ccomincini/quad_watch_winder/2_orologi/1227833-arduino-double-watch-winder-4b0ba891-c772-4ddb-af0b-a195a3b41aa9.pdf

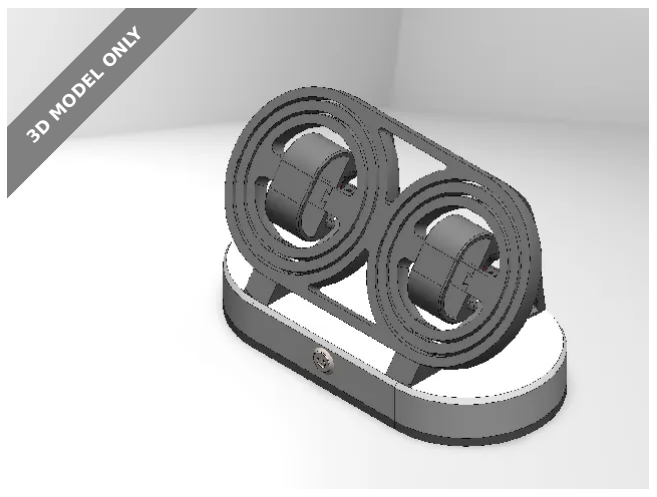
[picture p1: figure]
3D MODEL ONLY

## Summary

Device for spin up to two automatic watches

Hobby & Makers (https://printables.com/model?categoryId=48) > Electronics (https://printables.com/model?categoryId=52)

Functions

The watch winder keeps your automatic watch running when you're not wearing it. It's ideal if you own two watches and wear them alternately.

independently adjustable for both watches
adjustable spinning direction according to watch requirement adjustable spinning time according to watch requirement

Hardware and Software Used

Hardware:

1 pc. Arduino Uno
2 pcs. 28BYJ-48 Stepper Motor incl. Driver (Link) (https://de.aliexpress.com/item/1005007204939435.html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) 1 pc. 16mm Push Button (Link) (https://de.aliexpress.com/item/1005003595039032.html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)
10 pcs. Ball Bearing 603ZZ (Link) (https://de.aliexpress.com/item/1005004378774445.html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)
2 pcs. Ball Bearing SMR85ZZ (Link) (https://de.aliexpress.com/item/1005007618437178.html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)
22 pcs. Hex nut DIN934 - M3 (Link) (https://de.aliexpress.com/item/1005007593861199.html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)
22 pcs. Flat Head Screw ISO7380 - M3x6 (Link) (https://de.aliexpress.com/item/1005002136729466.html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) (IMPORTANT: Head Height max. 2mm)

JayS (https://printables.com/@JayS)

## Arduino Double Watch Winder

VIEW IN BROWSER (https://printables.com/model/1227833-arduino-double-watch-winder)

updated 6. 5. 2025 | published 6. 5. 2025

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
## Model files

18 pcs. Flat Head Screw ISO7380 - M3x10 (Link) (https://de.aliexpress.com/item/1005002136729466.html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) (IMPORTANT: Head Height max. 2mm)
Jumper cables for connection
USB cable for Arduino Uno

Software:

Tools used for development: Arduino IDE and Autodesk Inventor

Wiring Diagram

see Wiring.pdf

Code

see Code.ino. It includes descriptions for each section. To change runtime, adjust Step2Take value in the code.

Printing Instructions

prints great in PLA and also in PETG with some post processing of the parts. Simple open the 3MF file. It includes correct orientation and supports.

Assembly Instructions

For assembly please see the included pictures and especially the exploded view. I have also attached a .step file with the main parts.

•

•
•

uhrenbeweger.3mf

uhrenbeweger.step

## Other files

## License

This work is licensed under a
Creative Commons (4.0 International License)

Attribution—Noncommercial—Share Alike (http://creativecommons.org/licenses/by-nc-sa/4.0/)

✖ | Sharing without ATTRIBUTION
✔ | Remix Culture allowed
✖ | Commercial Use
✖ | Free Cultural Works
✖ | Meets Open Definition

code.ino

wiring.pdf
