ccomincini/quad_watch_winder/singolo/single-watch-winder-model_files/1290039-single-watch-winder-f3b908bd-97bc-490a-a9ca-4185cf84b470.pdf

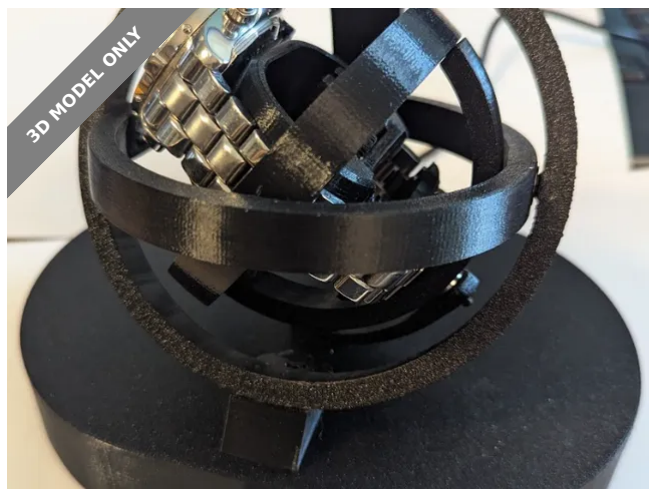
[picture p2: figure]
3D MODEL ONLY

## Summary

Device to keep an automatic winding watch wound.

Hobby & Makers (https://printables.com/model?categoryId=48) > Electronics (https://printables.com/model?categoryId=52)

Watch winder for a single watch. It's a remix of a double done to accommodate a single watch.

All parts per the original design except as follows:

New base (modified for a 5.5x2.1 power jack I had, plus a smaller power switch (NKK HB16 series that I also had)
New bottom cover (to match the new base)
New single outer ring

I used an Arduino Pro Micro (that I had on hand), so there are no mount holes for the Arduino. Code not attached here, as it's the same as the original, just with the second output commented out and adjusted for the Pro Micro pinout.

Remaining credit to @JayS for the original design.

## This remix is based on

R (https://printables.com/@RobbieKieffe_1050445) Robbie Kieffer (https://printables.com/@RobbieKieffe_1050445)

## Single Watch Winder

VIEW IN BROWSER (https://printables.com/model/1290039-single-watch-winder)

updated 8. 5. 2025 | published 8. 5. 2025

•

•
•

## Model files

Arduino Double Watch Winder (https://printables.com/model/1227833-arduino-double-watch-winder) by JayS (https://printables.com/@JayS)

## License

This work is licensed under a
Creative Commons (4.0 International License)

Attribution—Noncommercial—Share Alike (http://creativecommons.org/licenses/by-nc-sa/4.0/)

✖ | Sharing without ATTRIBUTION
✔ | Remix Culture allowed
✖ | Commercial Use
✖ | Free Cultural Works
✖ | Meets Open Definition

watchwinder_single_body.stl

watchwinder_single_base.stl

watchwinder_singlering.stl
