ccomincini/quad_watch_winder/2_orologi/uhrenbeweger.step

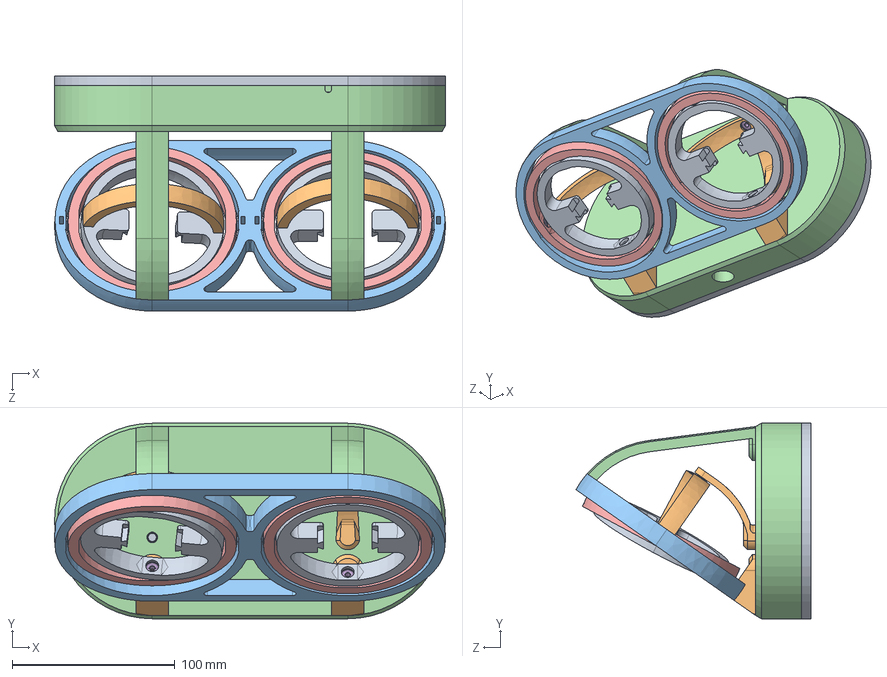
[picture p3: CAD file, 2026-10-13]
2_orologi/uhrenbeweger.step
240.0 x 120.0 x 144.3 mm
Deckel_R01.ipt
Sockel_links_unten_R01.ipt
Sockel_rechts_unten_R01.ipt
Ring_außen_R01.ipt
Sockel_links_oben_R01.ipt
Sockel_rechts_oben_R01.ipt
Ring_mitte_R01.ipt x 2
W 603 X-2Z_PART1.ipt x 10
W 603 X-2Z_PART2.ipt x 10
W 603 X-2Z_PART3.ipt x 60
Ring_innen_R01.ipt x 2
Ring_innen_Beweger_R01.ipt x 2
Motor.ipt
Gehäuse_R02.ipt
inafag_smr85-2z_ap1q6cxd37tek3q3ruj9lu0ju_01.ipt x 2
inafag_smr85-2z_ap1q6cxd37tek3q3ruj9lu0ju_02.ipt x 2
inafag_smr85-2z_ap1q6cxd37tek3q3ruj9lu0ju_03.ipt x 2
inafag_smr85-2z_ap1q6cxd37tek3q3ruj9lu0ju_04.ipt x 2
inafag_smr85-2z_ap1q6cxd37tek3q3ruj9lu0ju_05.ipt x 2
inafag_smr85-2z_ap1q6cxd37tek3q3ruj9lu0ju_06.ipt x 2
inafag_smr85-2z_ap1q6cxd37tek3q3ruj9lu0ju_07.ipt x 2
inafag_smr85-2z_ap1q6cxd37tek3q3ruj9lu0ju_08.ipt x 2
inafag_smr85-2z_ap1q6cxd37tek3q3ruj9lu0ju_09.ipt x 2
inafag_smr85-2z_ap1q6cxd37tek3q3ruj9lu0ju_10.ipt x 2
inafag_smr85-2z_ap1q6cxd37tek3q3ruj9lu0ju_11.ipt x 2
inafag_smr85-2z_ap1q6cxd37tek3q3ruj9lu0ju_12.ipt x 2
inafag_smr85-2z_ap1q6cxd37tek3q3ruj9lu0ju_13.ipt x 2
inafag_smr85-2z_ap1q6cxd37tek3q3ruj9lu0ju_14.ipt x 2
inafag_smr85-2z_ap1q6cxd37tek3q3ruj9lu0ju_15.ipt x 2
Beweger_R02.ipt
