ccomincini/quad_watch_winder/2_orologi/watchwinder_2_posti_stl/Uhrenbeweger.iam_watchwinder_2_posti v3_Sockel_rechts_oben_R01.ipt_1_Corpo1.stl

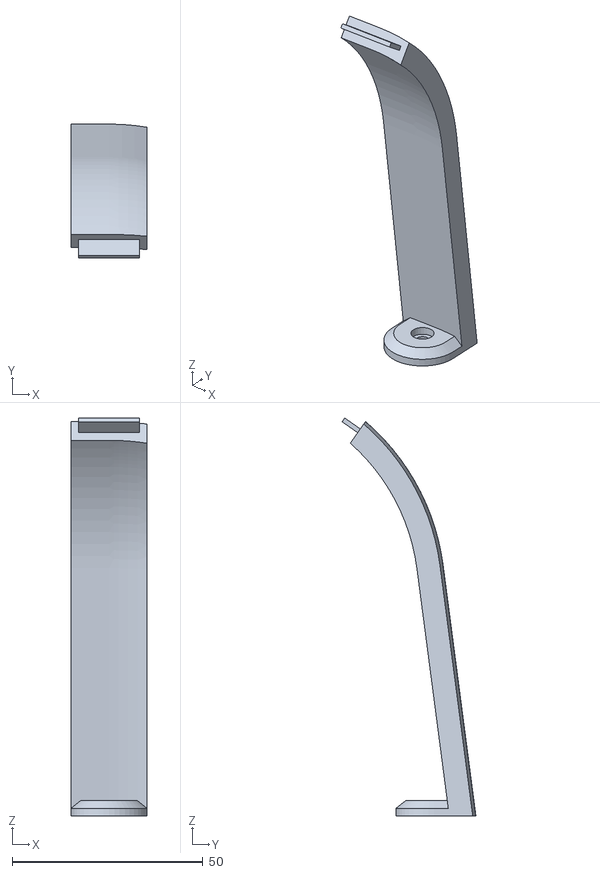
[picture p4: CAD file, 2026-11-06]
2_orologi/watchwinder_2_posti_stl/Uhrenbeweger.iam_watchwinder_2_posti v3_Sockel_rechts_oben_R01.ipt_1_Corpo1.stl
20.0 x 35.1 x 104.3
