ccomincini/quad_watch_winder/quad-watch-winder-model_files/base_3.stl

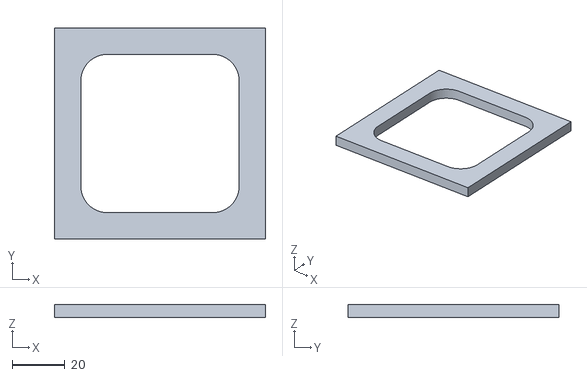
[picture p5: CAD file, 2026-09-02]
quad-watch-winder-model_files/base_3.stl
80.0 x 80.0 x 5.00
