ccomincini/quad_watch_winder/singolo/single-watch-winder-model_files/watchwinder_single_base_round.stl

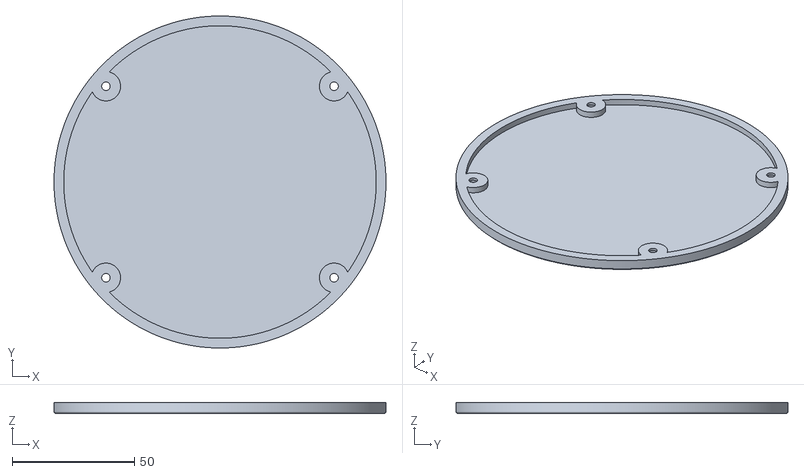
[picture p6: CAD file, 2026-11-06]
singolo/single-watch-winder-model_files/watchwinder_single_base_round.stl
136.0 x 136.0 x 4.50
