ccomincini/quad_watch_winder/singolo/singolo.3mf

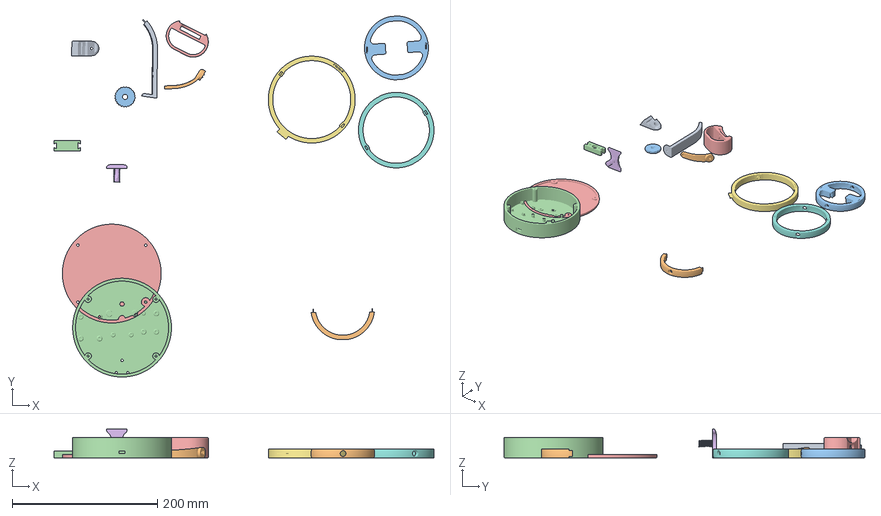
[picture p7: CAD file, 2026-11-06]
singolo/singolo.3mf
523.2 x 497.0 x 39.7 mm
Sockel_links_oben_R01.stl
Ring_innen_Beweger_R01.stl
Ring_innen_R01.stl
watchwinder_single_body_round.stl
Uhrträger_R01.stl
Uhrträger_Block_R03.stl
watchwinder_singlering.stl
Ring_mitte_R01.stl
Sockel_links_unten_R01.stl
Beweger_R02.stl
Uhrträger_Handrad_R03.stl
Uhrträger_Strebe_R01.stl
watchwinder_single_base_round.stl
