ccomincini/quad_watch_winder/2_orologi/watchwinder_2_posti_stl/Uhrenbeweger.iam_watchwinder_2_posti v3_Gehäuse_R02.ipt_1_Corpo1.stl

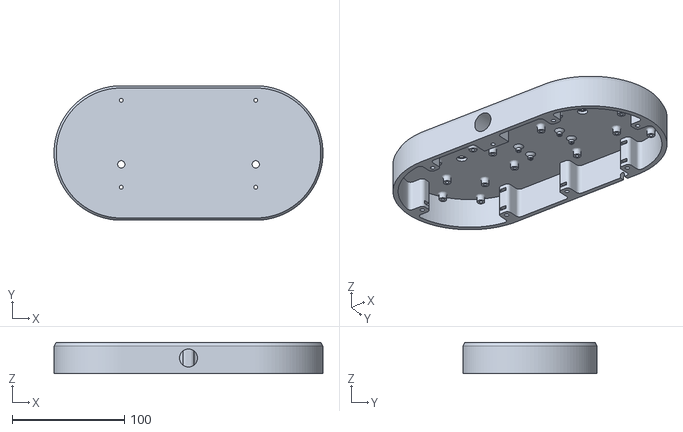
[picture p8: CAD file, 2026-11-06]
2_orologi/watchwinder_2_posti_stl/Uhrenbeweger.iam_watchwinder_2_posti v3_Gehäuse_R02.ipt_1_Corpo1.stl
240.0 x 120.0 x 28.0
