ccomincini/quad_watch_winder/quad-watch-winder-model_files/midplate.stl

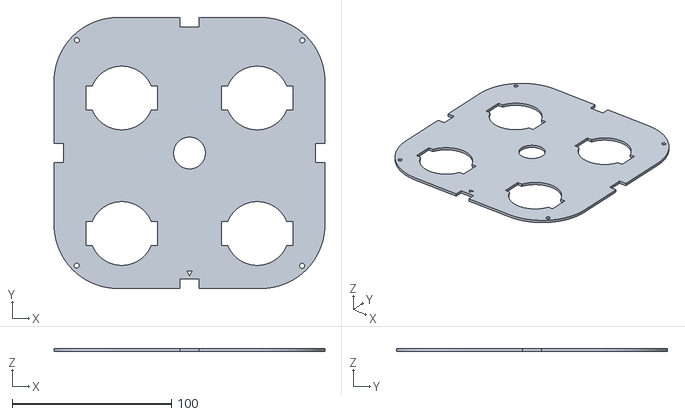
[picture p9: CAD file, 2026-09-02]
quad-watch-winder-model_files/midplate.stl
170.0 x 170.0 x 2.00
