ccomincini/quad_watch_winder/singolo/single-watch-winder-model_files/watchwinder_single_body_round.stl

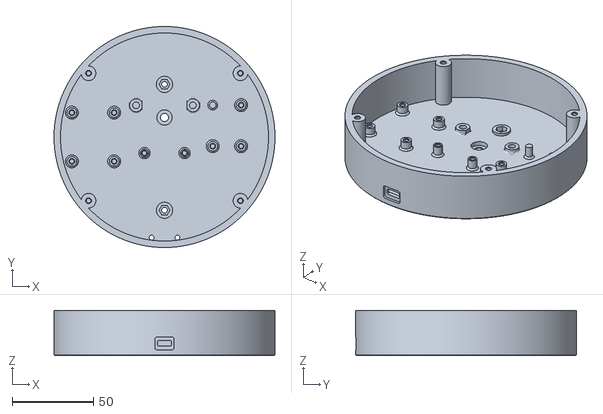
[picture p10: CAD file, 2026-11-06]
singolo/single-watch-winder-model_files/watchwinder_single_body_round.stl
136.0 x 136.0 x 28.0
