ccomincini/quad_watch_winder/quad-watch-winder-model_files/base_1.stl

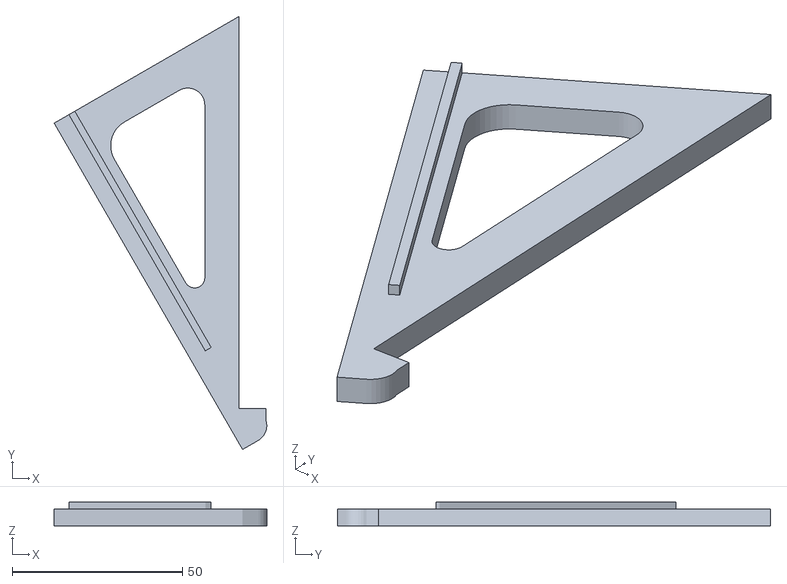
[picture p12: CAD file, 2026-09-02]
quad-watch-winder-model_files/base_1.stl
62.4 x 127.0 x 7.00
