ccomincini/quad_watch_winder/singolo/single-watch-winder-model_files/watchwinder_single_body_nodemcu.stl

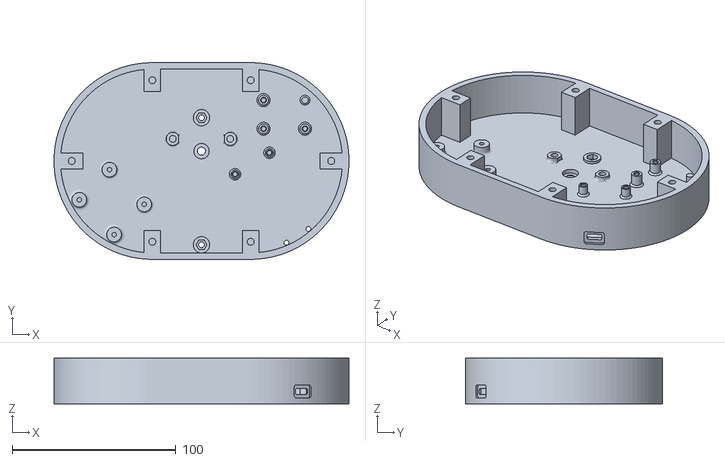
[picture p13: CAD file, 2026-11-01]
singolo/single-watch-winder-model_files/watchwinder_single_body_nodemcu.stl
179.9 x 120.0 x 28.0
