ccomincini/quad_watch_winder/2_orologi/watchwinder_2_posti_stl/Uhrenbeweger.iam_watchwinder_2_posti v3_Ring_mitte_R01.ipt_2_Corpo1.stl

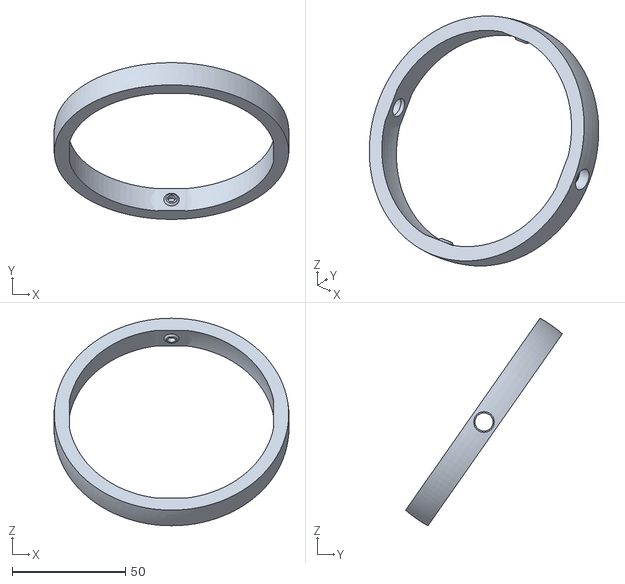
[picture p14: CAD file, 2026-11-06]
2_orologi/watchwinder_2_posti_stl/Uhrenbeweger.iam_watchwinder_2_posti v3_Ring_mitte_R01.ipt_2_Corpo1.stl
103.6 x 69.1 x 91.5
