ccomincini/quad_watch_winder/quad-watch-winder-model_files/plug.stl

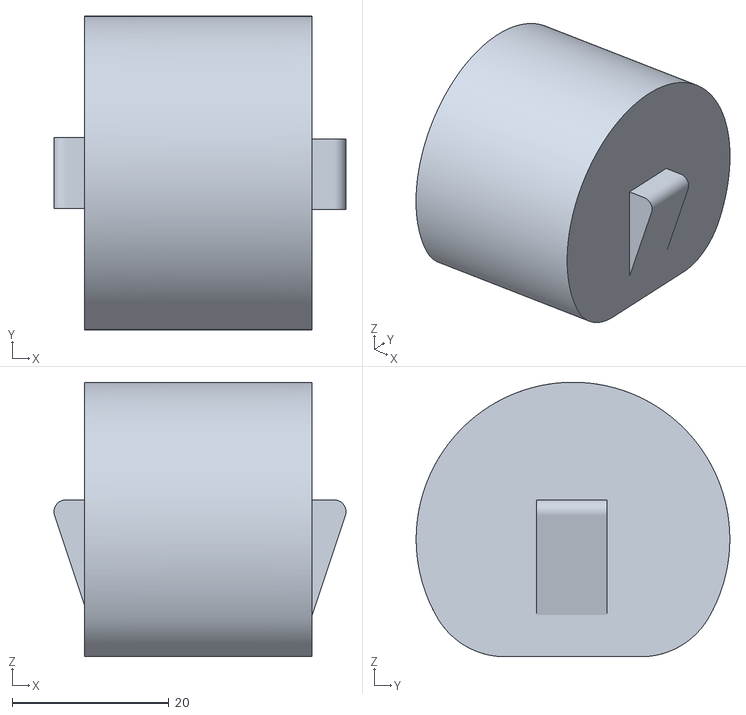
[picture p15: CAD file, 2026-09-02]
quad-watch-winder-model_files/plug.stl
37.2 x 40.0 x 35.0
