ccomincini/quad_watch_winder/singolo/single-watch-winder-model_files/Beweger_R02.stl

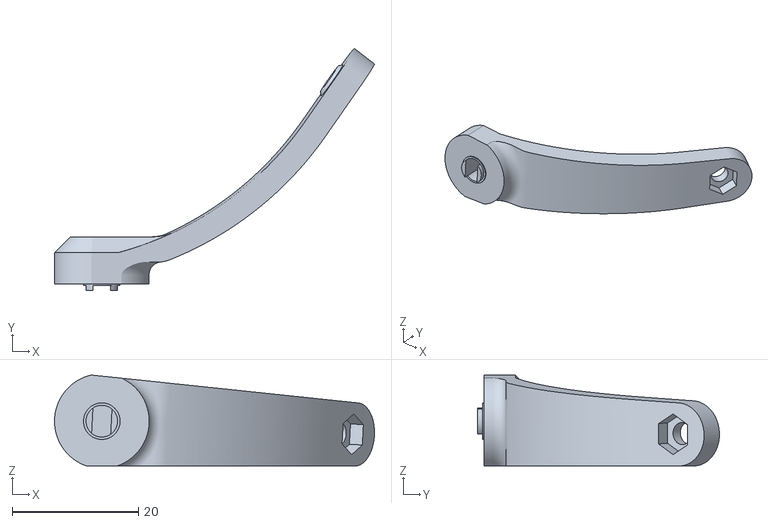
[picture p16: CAD file, 2026-10-30]
singolo/single-watch-winder-model_files/Beweger_R02.stl
50.7 x 38.3 x 14.4
