ccomincini/quad_watch_winder/2_orologi/watchwinder_2_posti_stl/Uhrenbeweger.iam_watchwinder_2_posti v3_Ring_innen_R01.ipt_1_Corpo1.stl

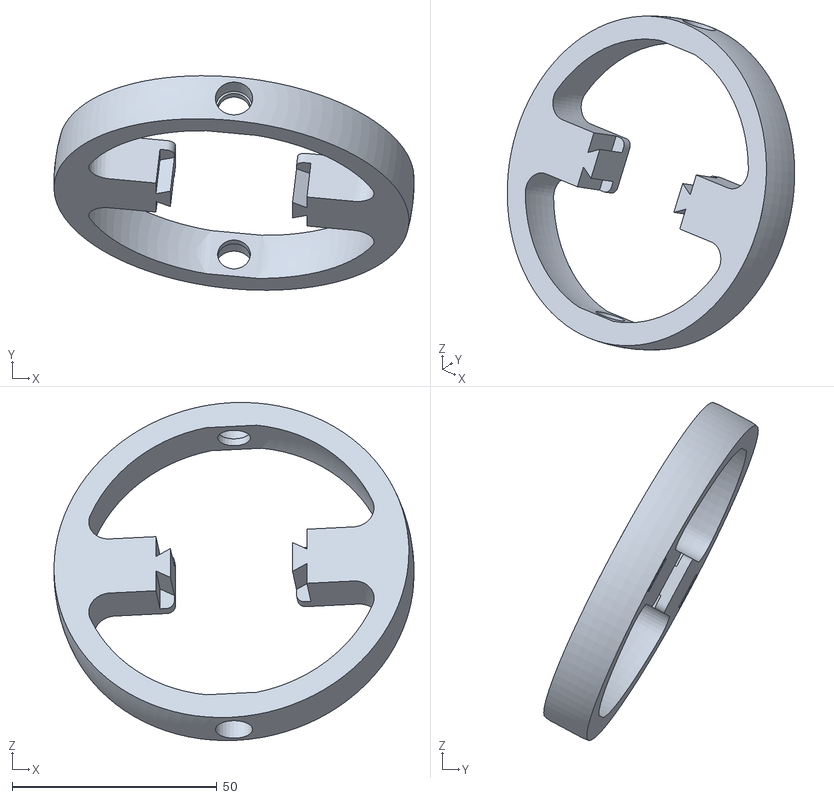
[picture p17: CAD file, 2026-11-06]
2_orologi/watchwinder_2_posti_stl/Uhrenbeweger.iam_watchwinder_2_posti v3_Ring_innen_R01.ipt_1_Corpo1.stl
88.0 x 52.4 x 82.6
