ccomincini/quad_watch_winder/quad-watch-winder-model_files/holder-foro-allargato.stl

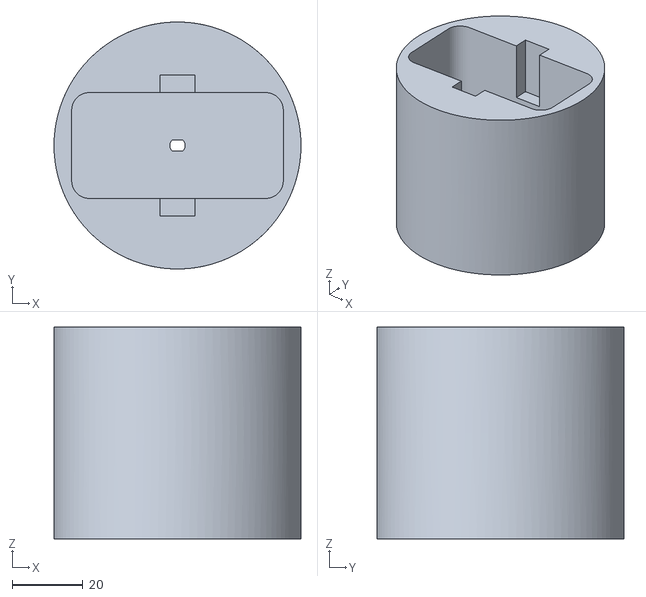
[picture p18: CAD file, 2026-09-02]
quad-watch-winder-model_files/holder-foro-allargato.stl
70.0 x 70.0 x 60.0
