ccomincini/quad_watch_winder/singolo/single-watch-winder-model_files/watchwinder_singlering.stl

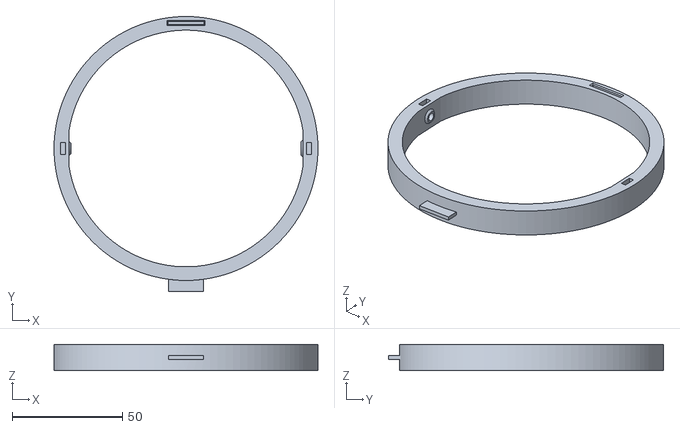
[picture p19: CAD file, 2026-10-30]
singolo/single-watch-winder-model_files/watchwinder_singlering.stl
119.6 x 124.6 x 12.0
