ccomincini/quad_watch_winder/singolo/single-watch-winder-model_files/Ring_mitte_R01.stl

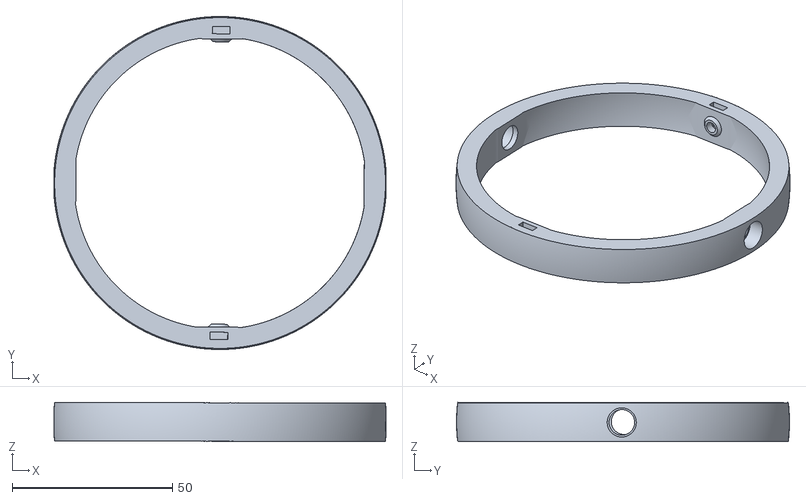
[picture p21: CAD file, 2026-10-30]
singolo/single-watch-winder-model_files/Ring_mitte_R01.stl
103.7 x 104.0 x 12.3
