ccomincini/quad_watch_winder/singolo/single-watch-winder-model_files/Uhrträger_Block_R03.stl

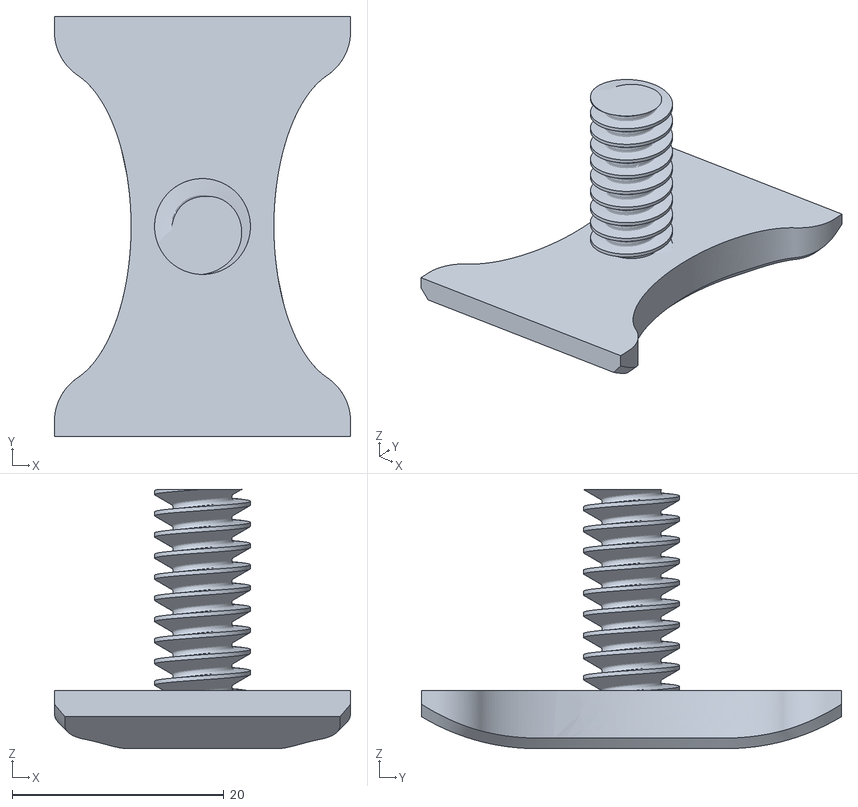
[picture p22: CAD file, 2026-10-30]
singolo/single-watch-winder-model_files/Uhrträger_Block_R03.stl
28.0 x 39.7 x 24.5
