ccomincini/quad_watch_winder/2_orologi/watchwinder_2_posti_stl/Uhrenbeweger.iam_watchwinder_2_posti v3_Ring_mitte_R01.ipt_1_Corpo1.stl

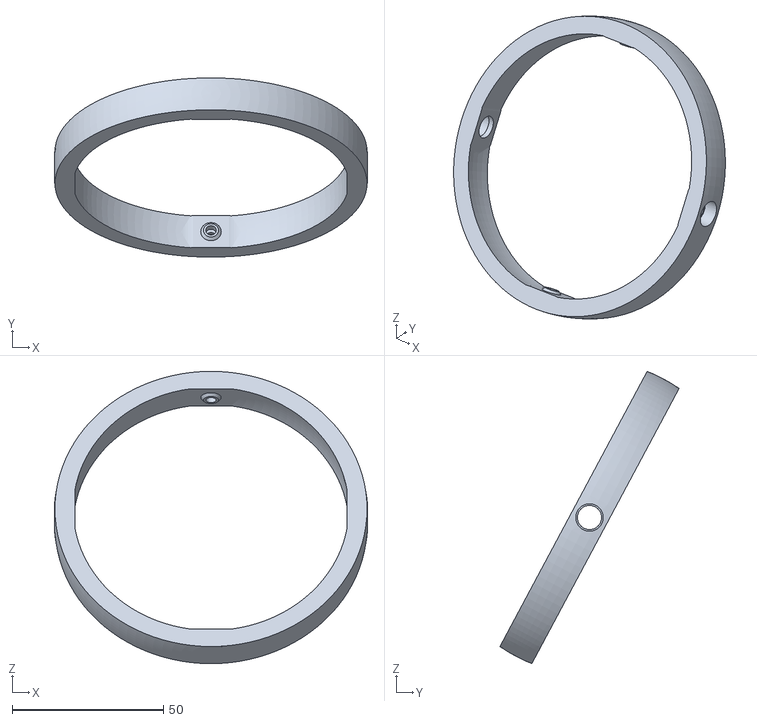
[picture p23: CAD file, 2026-11-06]
2_orologi/watchwinder_2_posti_stl/Uhrenbeweger.iam_watchwinder_2_posti v3_Ring_mitte_R01.ipt_1_Corpo1.stl
103.6 x 59.3 x 96.7
