ccomincini/quad_watch_winder/quad-watch-winder-model_files/cover.stl

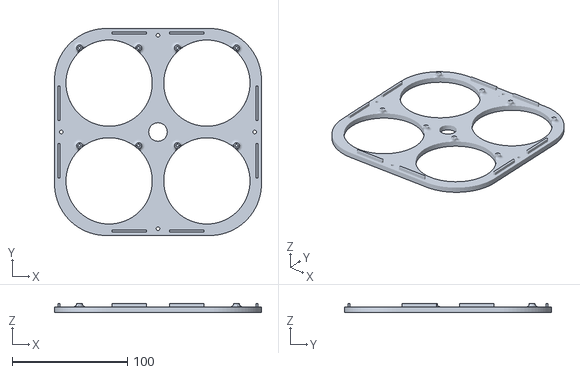
[picture p24: CAD file, 2026-09-02]
quad-watch-winder-model_files/cover.stl
180.0 x 180.0 x 8.00
