ccomincini/quad_watch_winder/singolo/single-watch-winder-model_files/Sockel_links_oben_R01.stl

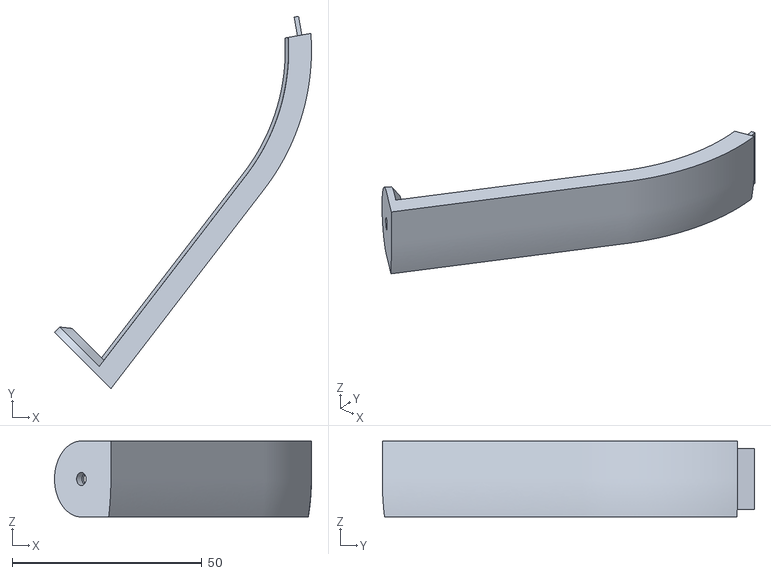
[picture p25: CAD file, 2026-10-30]
singolo/single-watch-winder-model_files/Sockel_links_oben_R01.stl
67.7 x 98.1 x 20.0
