ccomincini/quad_watch_winder/quad-watch-winder-model_files/box.3mf

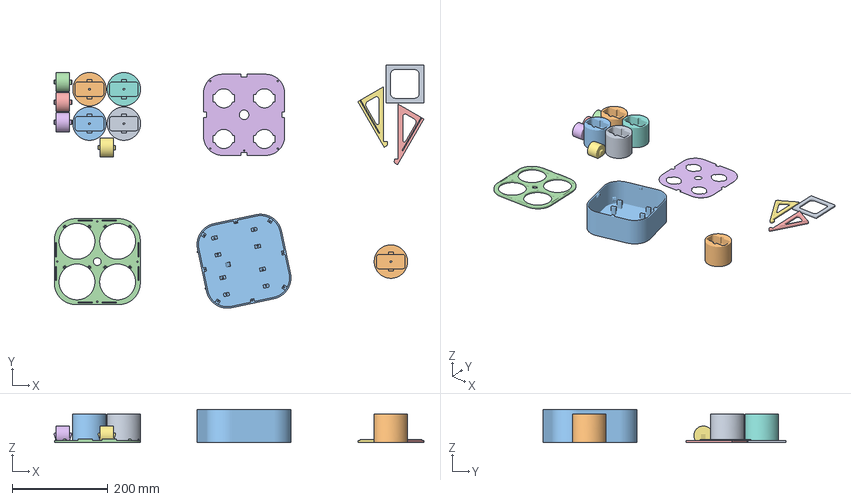
[picture p27: CAD file, 2026-09-02]
quad-watch-winder-model_files/box.3mf
774.4 x 509.3 x 70.0 mm
base_3.stl
holder_foro_motore_allargsato_2decimi.stl
box.stl
cover.stl
base_2.stl
midplate.stl
base_1.stl
holder.stl x 4
plug.stl x 4
