ccomincini/quad_watch_winder/singolo/single-watch-winder-model_files/Sockel_links_unten_R01.stl

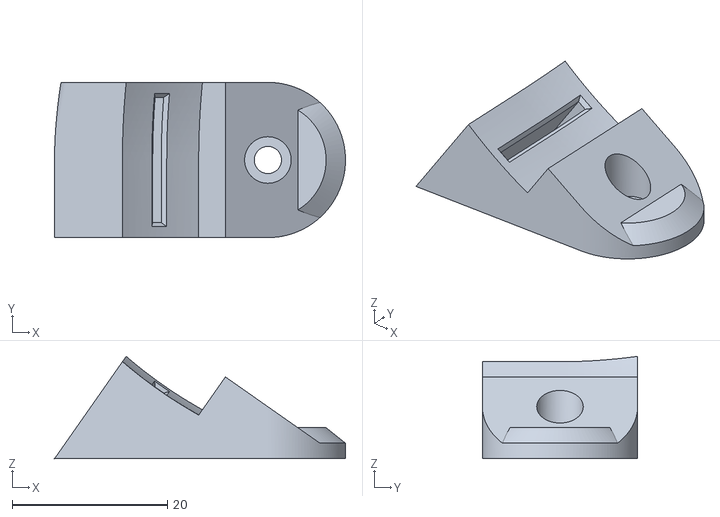
[picture p28: CAD file, 2026-10-30]
singolo/single-watch-winder-model_files/Sockel_links_unten_R01.stl
37.5 x 20.0 x 13.2
