ccomincini/quad_watch_winder/singolo/single-watch-winder-model_files/Ring_innen_Beweger_R01.stl

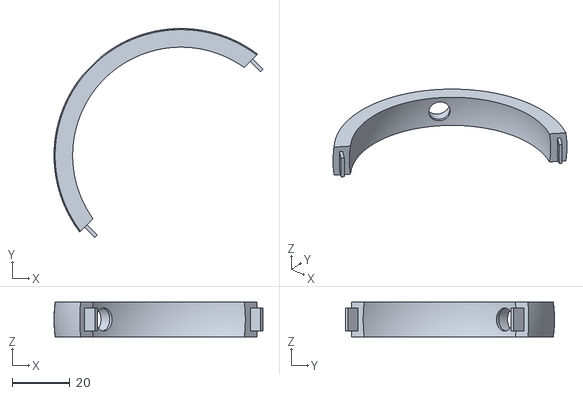
[picture p29: CAD file, 2026-10-30]
singolo/single-watch-winder-model_files/Ring_innen_Beweger_R01.stl
72.4 x 72.4 x 12.0
