ccomincini/quad_watch_winder/2_orologi/watchwinder_2_posti_stl/Uhrenbeweger.iam_watchwinder_2_posti v3_Ring_innen_Beweger_R01.ipt_1_Corpo1.stl

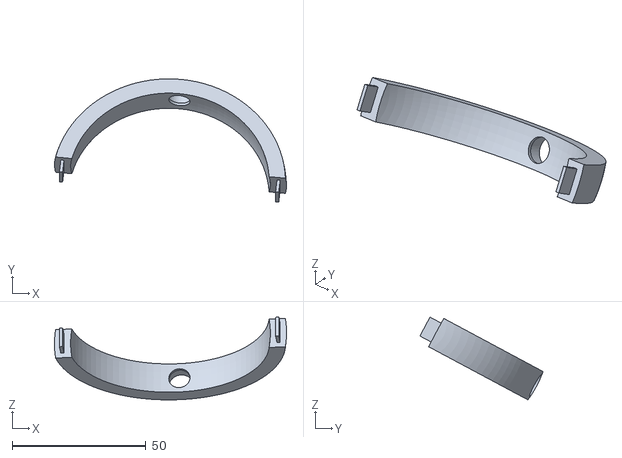
[picture p30: CAD file, 2026-11-06]
2_orologi/watchwinder_2_posti_stl/Uhrenbeweger.iam_watchwinder_2_posti v3_Ring_innen_Beweger_R01.ipt_1_Corpo1.stl
86.7 x 46.0 x 30.9
