ccomincini/quad_watch_winder/singolo/single-watch-winder-model_files/Ring_innen_R01.stl

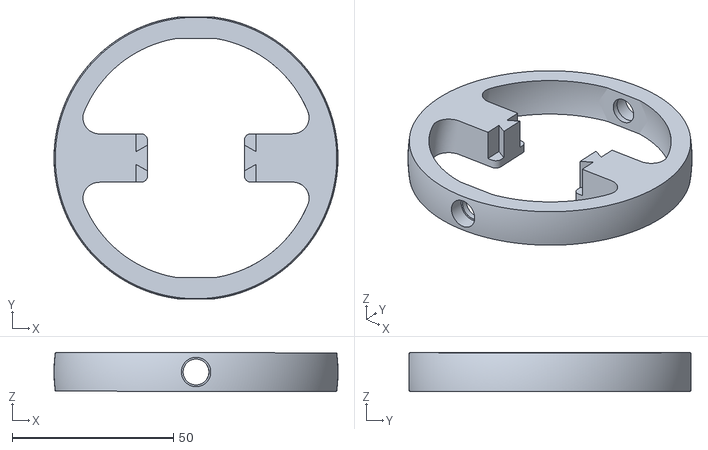
[picture p31: CAD file, 2026-10-30]
singolo/single-watch-winder-model_files/Ring_innen_R01.stl
88.0 x 87.5 x 12.1
