ccomincini/quad_watch_winder/singolo/single-watch-winder-model_files/Uhrträger_Handrad_R03.stl

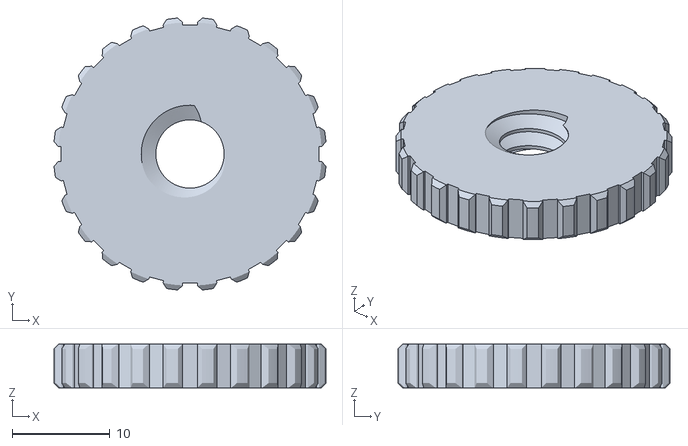
[picture p33: CAD file, 2026-10-30]
singolo/single-watch-winder-model_files/Uhrträger_Handrad_R03.stl
27.9 x 27.9 x 4.50
