ccomincini/quad_watch_winder/2_orologi/watchwinder_2_posti_stl/watchwinder_2_posti_arduinonano.3mf

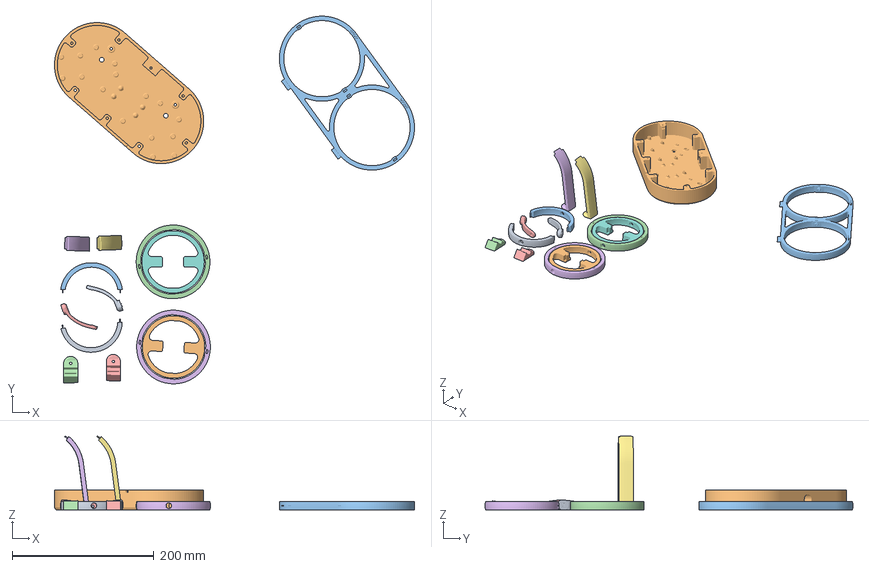
[picture p34: CAD file, 2026-11-06]
2_orologi/watchwinder_2_posti_stl/watchwinder_2_posti_arduinonano.3mf
507.7 x 518.6 x 104.3 mm
Uhrenbeweger.iam_watchwinder_2_posti v3_Beweger_R02.ipt_1_Corpo1.stl x 2
Uhrenbeweger.iam_watchwinder_2_posti v3_Gehäuse_R02.ipt_1_Corpo1.stl
Uhrenbeweger.iam_watchwinder_2_posti v3_Ring_außen_R01.ipt_1_Corpo1.stl
Uhrenbeweger.iam_watchwinder_2_posti v3_Ring_mitte_R01.ipt_2_Corpo1.stl
Uhrenbeweger.iam_watchwinder_2_posti v3_Ring_mitte_R01.ipt_1_Corpo1.stl
Uhrenbeweger.iam_watchwinder_2_posti v3_Sockel_rechts_oben_R01.ipt_1_Corpo1.stl
Uhrenbeweger.iam_watchwinder_2_posti v3_Ring_innen_R01.ipt_2_Corpo1.stl
Uhrenbeweger.iam_watchwinder_2_posti v3_Ring_innen_Beweger_R01.ipt_1_Corpo1.stl
Uhrenbeweger.iam_watchwinder_2_posti v3_Ring_innen_R01.ipt_1_Corpo1.stl
Uhrenbeweger.iam_watchwinder_2_posti v3_Ring_innen_Beweger_R01.ipt_2_Corpo1.stl
Uhrenbeweger.iam_watchwinder_2_posti v3_Sockel_rechts_unten_R01.ipt_1_Corpo1.stl
Uhrenbeweger.iam_watchwinder_2_posti v3_Sockel_links_unten_R01.ipt_1_Corpo1.stl
Uhrenbeweger.iam_watchwinder_2_posti v3_Sockel_links_oben_R01.ipt_1_Corpo1.stl
