ccomincini/quad_watch_winder/singolo/single-watch-winder-model_files/watchwinder_single_base.stl

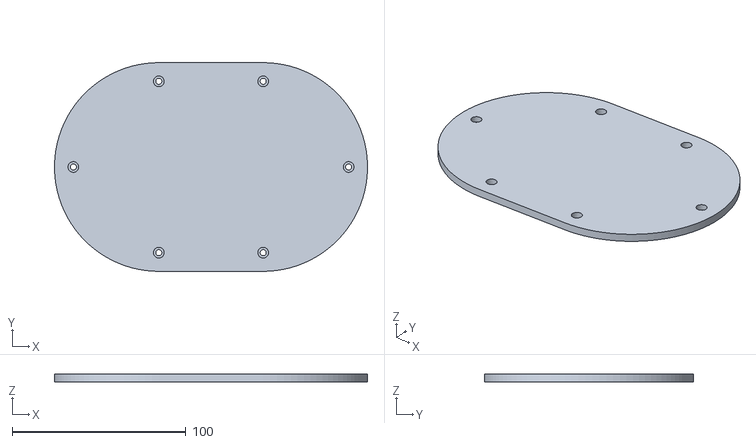
[picture p35: CAD file, 2026-10-30]
singolo/single-watch-winder-model_files/watchwinder_single_base.stl
179.9 x 120.0 x 4.50
