ccomincini/quad_watch_winder/singolo/single-watch-winder-model_files/Uhrträger_Strebe_R01.stl

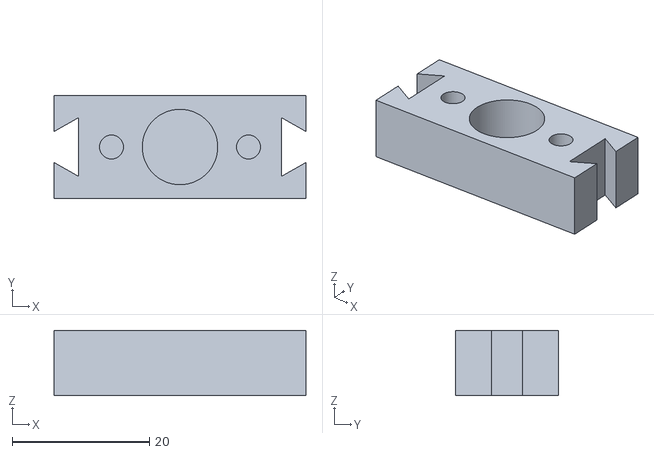
[picture p36: CAD file, 2026-10-30]
singolo/single-watch-winder-model_files/Uhrträger_Strebe_R01.stl
36.8 x 15.0 x 9.50
