ccomincini/quad_watch_winder/2_orologi/watchwinder_2_posti_stl/Uhrenbeweger.iam_watchwinder_2_posti v3_Ring_innen_R01.ipt_2_Corpo1.stl

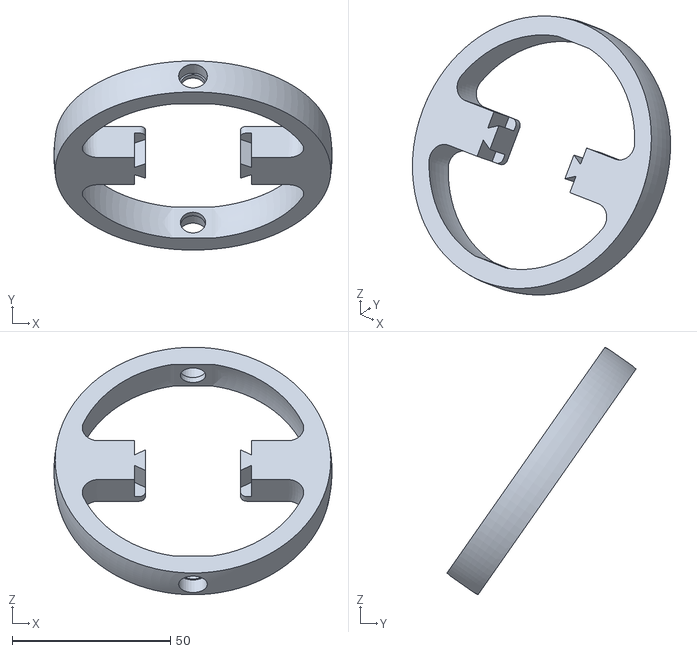
[picture p37: CAD file, 2026-11-06]
2_orologi/watchwinder_2_posti_stl/Uhrenbeweger.iam_watchwinder_2_posti v3_Ring_innen_R01.ipt_2_Corpo1.stl
87.9 x 59.8 x 78.3
