ccomincini/quad_watch_winder/singolo/single-watch-winder-model_files/Uhrträger_R01.stl

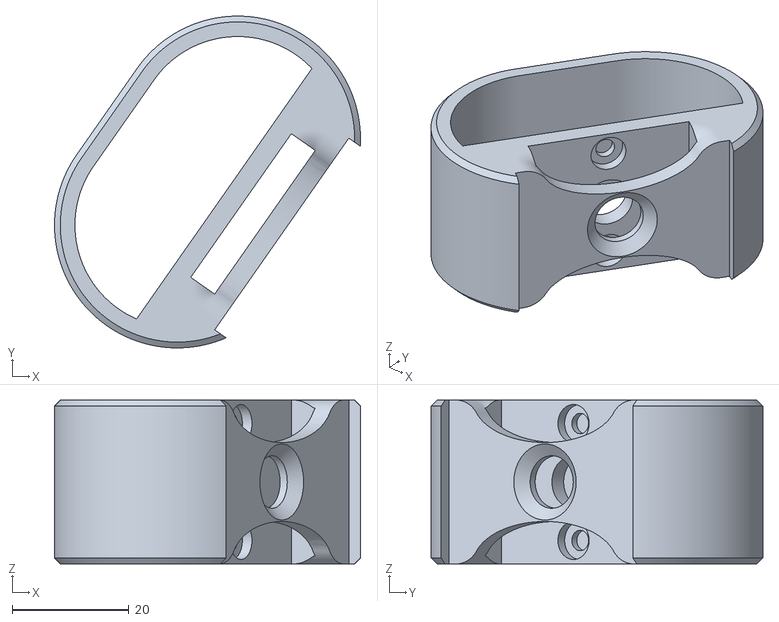
[picture p38: CAD file, 2026-10-30]
singolo/single-watch-winder-model_files/Uhrträger_R01.stl
52.3 x 56.7 x 28.0
