ccomincini/quad_watch_winder/(list of files, cad)

Other CAD files:
quad-watch-winder-model_files/base_2.stl
2_orologi/watchwinder_2_posti_stl/Uhrenbeweger.iam_watchwinder_2_posti v3_Sockel_rechts_unten_R01.ipt_1_Corpo1.stl
quad-watch-winder-model_files/holder.stl
2_orologi/watchwinder_2_posti_stl/Uhrenbeweger.iam_watchwinder_2_posti v3_Sockel_links_oben_R01.ipt_1_Corpo1.stl
2_orologi/watchwinder_2_posti_stl/Uhrenbeweger.iam_watchwinder_2_posti v3_Beweger_R02.ipt_1_Corpo1.stl
singolo/single-watch-winder-model_files/watchwinder_single_body.stl
singolo/single-watch-winder-model_files/watchwinder_single_body_round.scad
2_orologi/uhrenbeweger.3mf
quad-watch-winder-model_files/box.stl
quad-watch-winder-model_files/quad-watch-winder.f3d
