ccomincini/quad_watch_winder/2_orologi/wiring.pdf

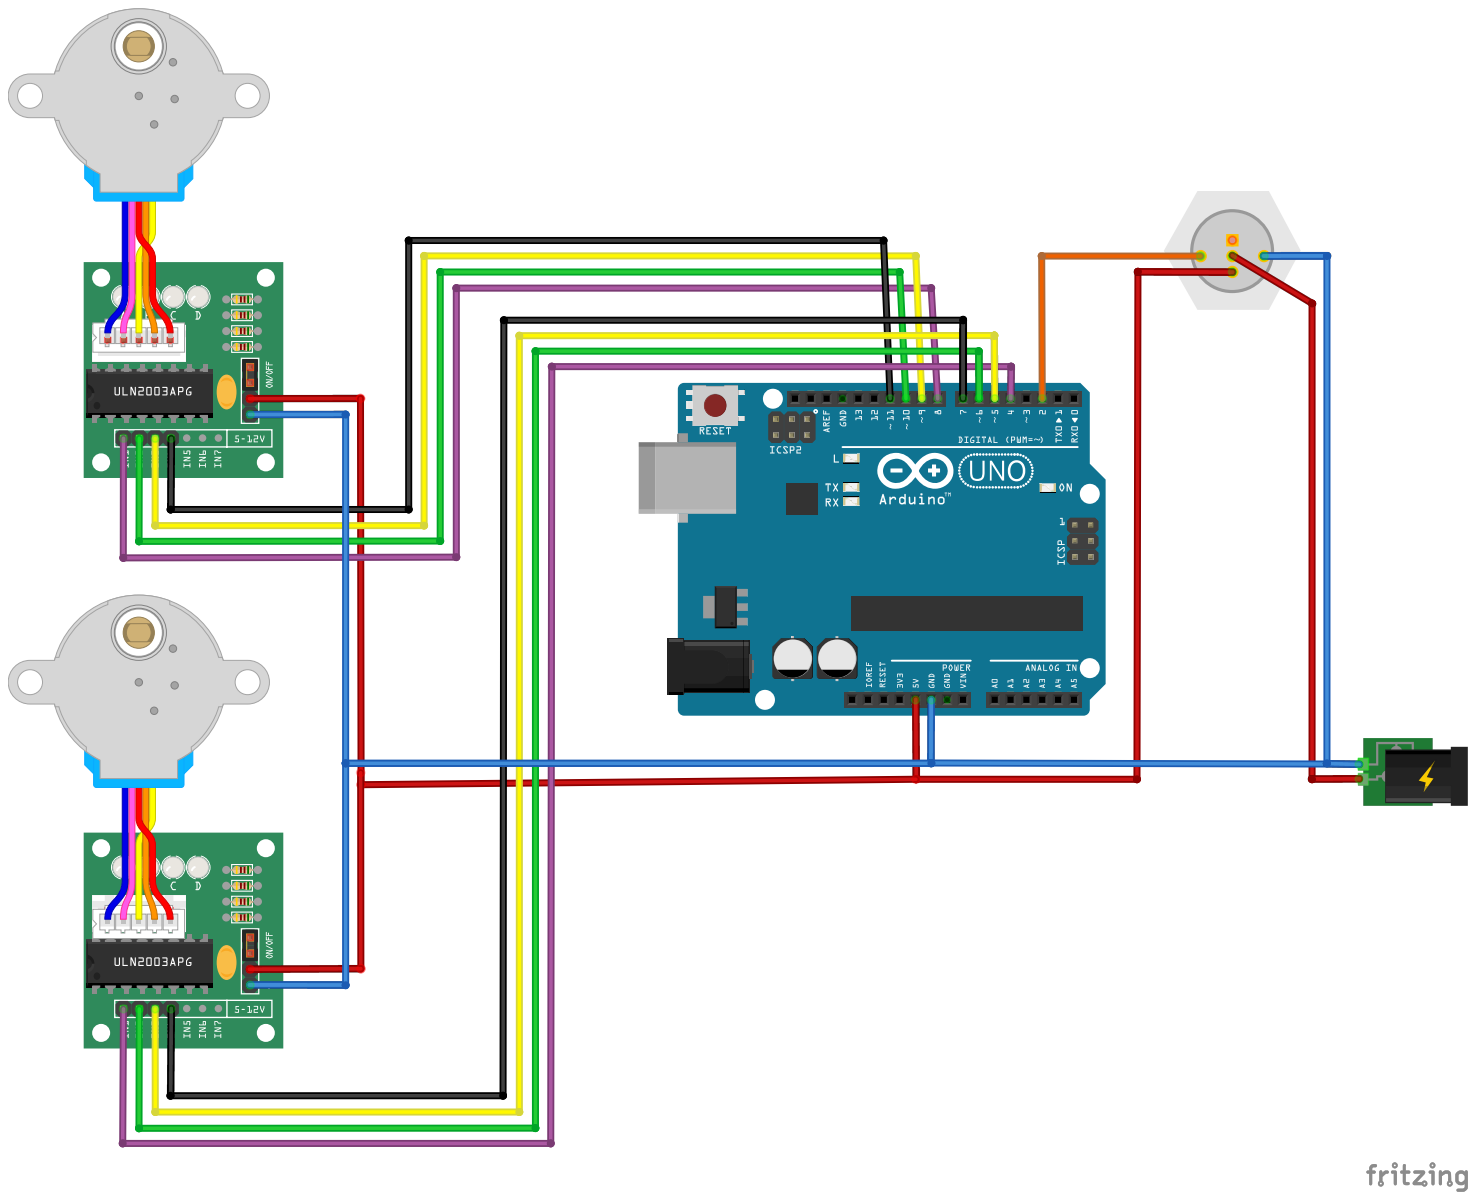
[picture p40: page 1]
