ccomincini/quad_watch_winder/(commit log)

2026-09-02 Primo rilascio: firmware Pico 2 W, documentazione e parti 3D
    Caricaorologi a quattro posti basato sul modello 3D "Quad Watch Winder"
    di Karel (Printables 25958, CC BY-NC 4.0), con elettronica e firmware
    rifatti attorno a un Raspberry Pi Pico 2 W e a un RTC DS3231.
    Rispetto all'originale ad ATmega328P: base dei tempi con RTC compensato
    in temperatura, configurazione da menu seriale invece che da pulsante,
    persistenza nella EEPROM AT24C32 del modulo RTC, fascia oraria di
    funzionamento e quota di giri calcolata dai TPD richiesti.
    Contenuto:
    - watchwinder/ firmware, nessuna libreria esterna, accesso diretto ai
    registri I2C del DS3231 e della EEPROM
    - doc/ schema elettrico con la di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
2026-10-13 Variante a 2 posti e correzione del salvataggio in EEPROM
    - Firmware: il checksum della configurazione includeva il proprio byte,
    quindi ogni configurazione salvata con 'w' veniva scartata alla
    riaccensione. Ora il calcolo si ferma prima del campo checksum.
    - Firmware: l'ora viene letta gia' in setup(), cosi' all'accensione i
    motori non partono per ripiego anche di notte.
    - Nuova cartella 2_orologi: meccanica "Arduino Double Watch Winder" di
    JayS (CC BY-NC-SA 4.0), sketch per Pico 2 W con valori per 2 posti
    (08-20, 1600 giri al giorno bidirezionali, 1900 us), schema elettrico,
    sketch per Arduino Nano non in uso.
    - README e LICENSE aggiornati con la variante e le sue licenze; corr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
2026-10-25 2 posti: fascia oraria per il fine settimana e ricerca dell'RTC
    - Seconda fascia oraria per sabato e domenica: di fabbrica 08-21 dal
    lunedi' al venerdi' e 10-21 nel fine settimana. Il comando 'h' accetta
    quattro valori (con due la stessa fascia vale tutti i giorni). Il
    giorno della settimana si ricava dalla data; i giri al giorno restano
    gli stessi e cambia la quota di ogni ciclo.
    - Se all'accensione l'RTC non risponde, il firmware lo cerca di nuovo
    ogni 5 secondi invece di girare per ripiego fino al riavvio.
    - La configurazione in EEPROM ha due campi in piu' (struttura sempre di
    32 byte): CONFIG_MAGIC del 2 posti portato a 0x57573203, distinto da
    quello del 4 posti, che resta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
2026-10-25 2 posti: ora da internet via wifi e ora legale automatica
    - Il DS3231 tiene l'ora UTC; il firmware la converte in ora italiana con
    il passaggio automatico fra ora solare e ora legale, che funziona anche
    senza rete. Il comando 'T' accetta l'ora italiana.
    - Sincronizzazione NTP (pool.ntp.org) all'accensione e poi ogni 12 ore,
    solo a motori fermi perche' il collegamento al wifi blocca il programma
    per qualche secondo; dopo un errore riprova fra 15 minuti.
    - Rete wifi salvata in un blocco separato della EEPROM con il comando
    'n <rete> <password>' ('n' sincronizza subito, 'n -' cancella): nome e
    password non compaiono mai nel codice.
    - Un RTC azzerato (data precedente al 2026, contatt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
2026-10-25 2 posti: pulsante senza LED, alimentazione solo da USB, GND del Pico
    - Il pulsante usato non ha LED: tolto dallo schema e dal README il LED
    spia fra i Wago.
    - Documentata l'alimentazione con il solo cavo USB: la corrente passa
    dal diodo fra VBUS e VSYS del Pico (1 A); serve un alimentatore USB da
    almeno 1 A e il pulsante in quel caso non spegne nulla.
    - Schema: il GND del Pico verso il Wago e' sul pin 3, non sul 38, che e'
    occupato dal GND del modulo RTC (come gia' indicato nel README).
2026-10-30 1 posto: scatola per NodeMCU V3 e modello di Robbie Kieffer
    Cartella singolo/ con il "Single Watch Winder" di Robbie Kieffer
    (Printables 1290039, remix del doppio di JayS, CC BY-NC-SA 4.0) e le parti
    di JayS per un posto.
    Scatola modificata watchwinder_single_body_nodemcu (STL e sorgente
    OpenSCAD, che importa lo STL originale):
    - chiusi il foro dell'interruttore e quello della presa, tolto il supporto
    interno dell'interruttore;
    - appoggi a vite per la NodeMCU V3, apertura per il micro USB, fori a
    imbuto con canna guida per RST e FLASH;
    - fori degli appoggi ULN2003 da 2,5 mm;
    - foro del supporto alto e sedi dei dadi M3 dei due supporti.
    Il coperchio inferiore originale resta compatibile.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
2026-10-31 1 posto: NodeMCU infilata nella parete e appoggi per l'RTC
    - NodeMCU: il lato del micro USB entra in una fessura nella parete curva,
    con una finestra di 8,6 x 3,6 mm per la presa e un incavo esterno di
    12 x 8 mm per la plastica della spina; avvitata solo sul lato
    dell'antenna, fori allontanati a 24,2 mm sul lato corto.
    - Modulo RTC DS3231: quattro appoggi (tre sotto i fori, uno d'angolo),
    due viti M3x8 in diagonale, batteria verso il coperchio inferiore.
    - README aggiornato con montaggio e viti.
2026-11-01 1 posto: appoggi più robusti, fessura più larga, fori dei pulsanti diritti
    Ritocchi dopo la prova di stampa della versione del 31/10:
    - fori delle viti e dei pulsanti della NodeMCU allontanati di 0,5 mm;
    - pulsanti RST e FLASH: foro diritto da 3 mm nel piano superiore, senza
    imbuto e canna guida, che si chiudevano in stampa;
    - fessura della NodeMCU più larga di 0,5 mm per parte e scheda spinta
    0,2 mm verso l'esterno;
    - appoggi del modulo RTC più alti di 1,5 mm, per l'aria e per i connettori
    dei cavetti;
    - appoggi a vite con smusso a 45 gradi alla base e foro da 2,8 mm svasato
    (anche ULN2003); appoggi dell'RTC da 6 mm.
2026-11-06 1 posto: firmware per NodeMCU V3 e schema dei collegamenti
    Firmware watchwinder_1posto ricavato da quello del 2 posti, ridotto a un
    motore e portato sull'ESP8266: fasce orarie feriali e di fine settimana,
    RTC in UTC con ora legale calcolata, ora da internet ogni 12 ore con la
    radio spenta fra una sincronizzazione e l'altra, rete wifi salvata solo
    nella EEPROM del modulo RTC. Dopo la notte i cicli arretrati si
    recuperano in un colpo solo, senza ripetere la prima sessione.
    Schema elettrico con i collegamenti provati il 06/11/2026; README del
    singolo con collegamenti e firmware; firmware 1 posto sotto MIT.
2026-11-06 1 posto: 1200 us fra i passi e 800 giri al giorno
    Velocita' di fabbrica portata da 1900 a 1200 us: nelle prove con
    l'orologio montato e' risultata la piu' silenziosa fra 1200 e 4000 us.
    Giri di fabbrica portati da 1600 a 800 al giorno in entrambi i versi,
    per l'orologio a cui il caricatore e' destinato: un Longines automatico
    da donna degli anni '80 di calibro non noto (gli automatici da donna
    piu' diffusi, come l'ETA 2671, chiedono circa 650 giri al giorno).
2026-11-06 1 posto: configurazione dal telefono via wifi
    Due pressioni di RST a circa un secondo di distanza (o il comando 'k')
    fermano il motore e aprono la rete wifi "Watchwinder" con una pagina che
    il telefono apre da solo: rete wifi con l'elenco delle reti vicine, giri
    al giorno, verso, fasce orarie, velocita' e ora presa dal telefono. La
    password salvata non viene mai mostrata. La rete si spegne dopo il
    salvataggio o dopo 10 minuti senza attivita'.
    Il doppio RST usa la memoria RTC dell'ESP8266, che resiste al riavvio da
    pulsante. Resta anche il pulsante FLASH tenuto 3 secondi, che pero' sulla
    NodeMCU in uso non fa contatto.
2026-11-06 1 posto: scatola tonda da 136 mm
    Variante piu' piccola della scatola modificata, tonda da 136 mm invece di
    180 x 120 (circa il 22% di superficie in meno), con il suo coperchio
    inferiore fissato da quattro viti M3x8. Riprende dalla scatola di Robbie
    Kieffer gli attacchi del motore, la posizione dei supporti e l'altezza.
    Sorgenti OpenSCAD e STL, licenza CC BY-NC-SA 4.0 come l'originale.
2026-11-06 2 posti e 1 posto: STL esportati e progetti di stampa
    2_orologi/watchwinder_2_posti_stl/: parti del caricatore a 2 posti di
    JayS esportate dall'assieme con gli attacchi per l'Arduino Nano, e il
    progetto di stampa watchwinder_2_posti_arduinonano.3mf.
    singolo/singolo.3mf: progetto di stampa del caricatore a 1 posto.
    Licenza CC BY-NC-SA 4.0, come i modelli originali.
2026-11-06 2 posti: niente seconda sessione al mattino
    Dopo la notte i cicli arretrati si recuperavano uno per giro di loop(),
    lasciando la partenza armata: finita la prima sessione del mattino ne
    ripartiva subito un'altra (circa 31 giri in piu' al giorno). Ora si
    recuperano in un colpo solo, come nel firmware a 1 posto.
2026-11-06 4 posti: niente seconda sessione al mattino
    Stessa correzione del 2 posti: dopo la notte i cicli arretrati si
    recuperano in un colpo solo, cosi' la partenza non resta armata e la
    prima sessione del mattino non si ripete appena finita.
